yorkmodular-cc/avr-vco-attiny/attiny-vco.png

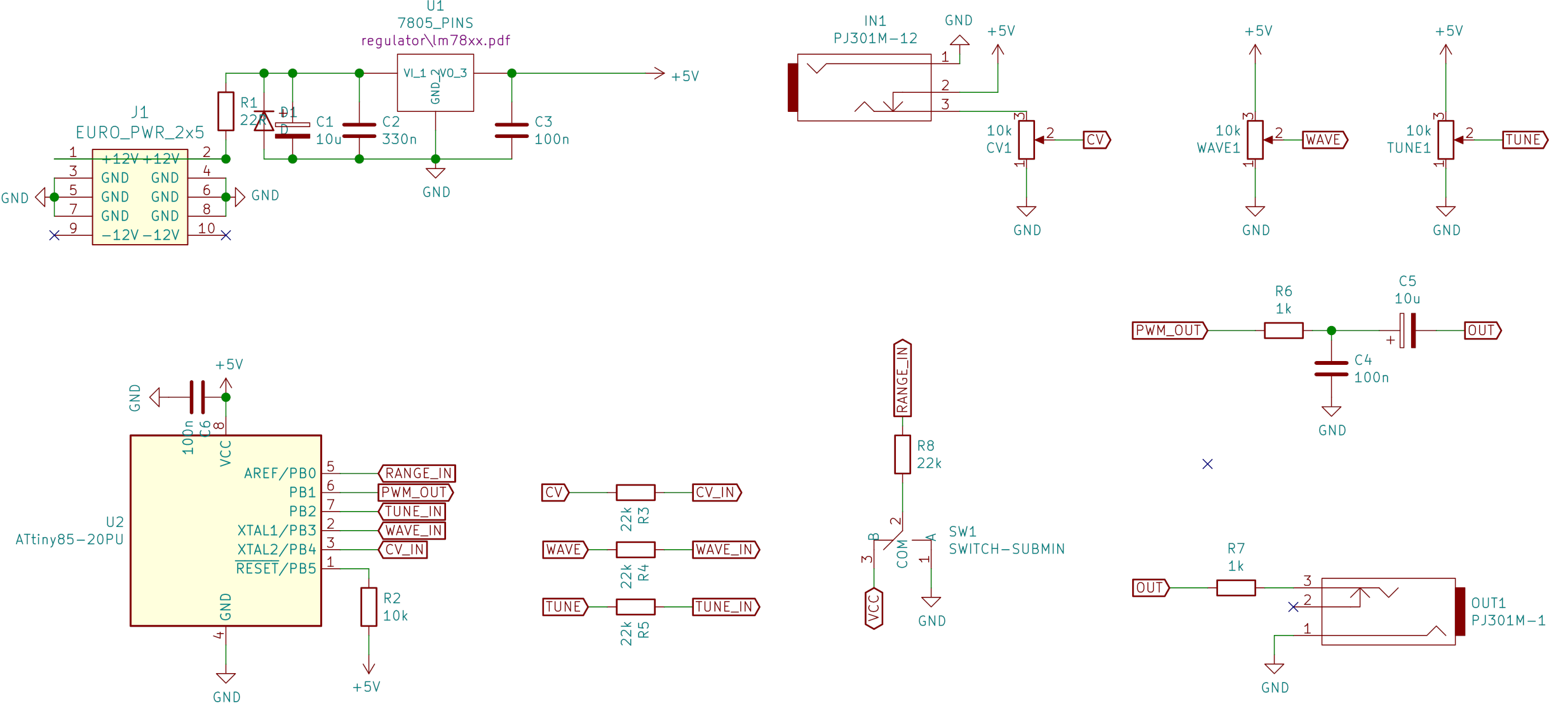
attiny-vco.png
