yorkmodular-cc/avr-vco-attiny/wavetables-attiny-finetune/wavetables.h

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
#include <stdint.h>
#include <avr/pgmspace.h>
#define WAVETABLE_LENGTH 256
#define MAPTABLE_LENGTH 1024


// 1V/octave lookup table - the values are phase increments. Base frequency is
// approximately 30Hz.
const uint16_t freqTable[MAPTABLE_LENGTH] PROGMEM = {
    69,69,69,69,70,70,70,70,70,71,71,71,71,72,72,72,72,73,73,73,73,74,74,74,
    74,75,75,75,75,76,76,76,76,77,77,77,77,78,78,78,79,79,79,79,80,80,80,80,
    81,81,81,81,82,82,82,83,83,83,83,84,84,84,85,85,85,85,86,86,86,87,87,87,
    88,88,88,88,89,89,89,90,90,90,91,91,91,91,92,92,92,93,93,93,94,94,94,95,
    95,95,96,96,96,97,97,97,98,98,98,99,99,99,100,100,100,101,101,101,102,102,
    102,103,103,103,104,104,104,105,105,105,106,106,106,107,107,108,108,108,
    109,109,109,110,110,111,111,111,112,112,112,113,113,114,114,114,115,115,
    115,116,116,117,117,117,118,118,119,119,119,120,120,121,121,122,122,122,
    123,123,124,124,124,125,125,126,126,127,127,127,128,128,129,129,130,130,
    130,131,131,132,132,133,133,134,134,134,135,135,136,136,137,137,138,138,
    139,139,140,140,141,141,141,142,142,143,143,144,144,145,145,146,146,147,
    147,148,148,149,149,150,150,151,151,152,152,153,153,154,155,155,156,156,
    157,157,158,158,159,159,160,160,161,161,162,163,163,164,164,165,165,166,
    166,167,168,168,169,169,170,170,171,172,172,173,173,174,175,175,176,176,
    177,178,178,179,179,180,181,181,182,182,183,184,184,185,185,186,187,187,
    188,189,189,190,191,191,192,193,193,194,194,195,196,196,197,198,198,199,
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
    0xa,0xb,0xc,0xe,0xf,0x11,0x12,0x14,0x15,0x17,0x19,0x1b,0x1d,0x1f,0x21,0x23,
    0x25,0x28,0x2a,0x2c,0x2f,0x31,0x34,0x36,0x39,0x3b,0x3e,0x41,0x43,0x46,0x49,0x4c,
    0x4f,0x52,0x55,0x58,0x5a,0x5d,0x61,0x64,0x67,0x6a,0x6d,0x70,0x73,0x76,0x79,0x7c
};
